regbundock/1002-Connection_Unit/1002-Connection_Unit.png

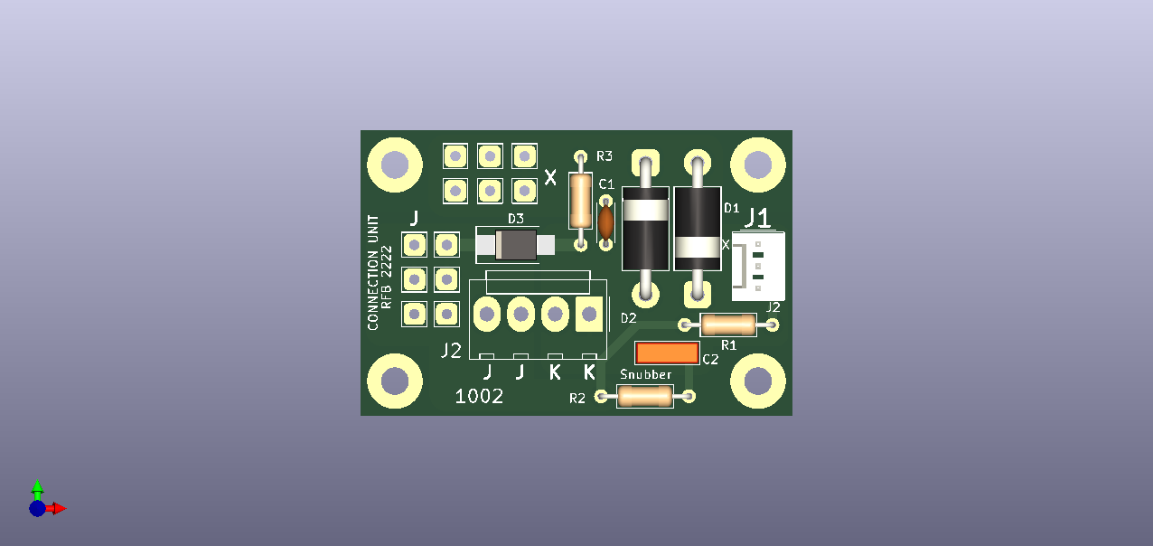
1002-Connection_Unit.png
