regbundock/1002-Connection_Unit/1002-Connection _Unit.pdf

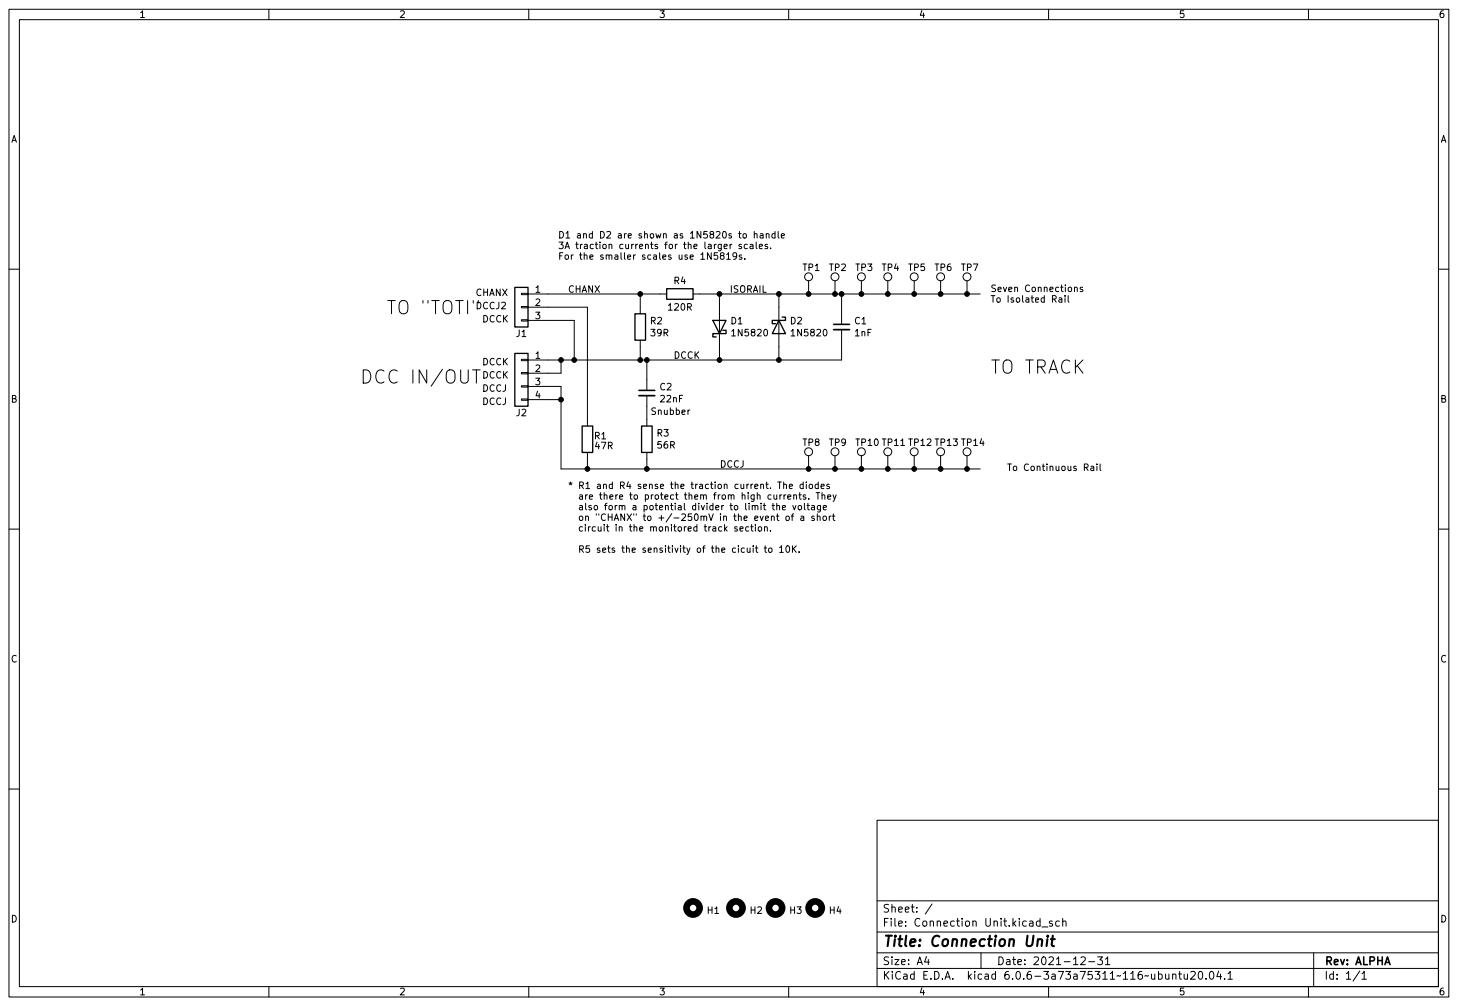
[picture p6: page 1]

Seven Connections To Isolated Rail D1 and D2 are shown as 1N5820s to handle
3A traction currents for the larger scales. For the smaller scales use 1N5819s.

To Continuous Rail TO "TOTI"

* R1 and R4 sense the traction current. The diodes
are there to protect them from high currents. They
also form a potential divider to limit the voltage
on "CHANX" to +/-250mV in the event of a short
circuit in the monitored track section.

File: Connection Unit.kicad_sch Sheet: /
Id: 1/1 Title: Connection Unit
