regbundock/1002-Connection_Unit/1002-Connection_Unit.kicad_pcb

## KiCad design 1002-Connection_Unit.kicad_pcb (2022-09-17)

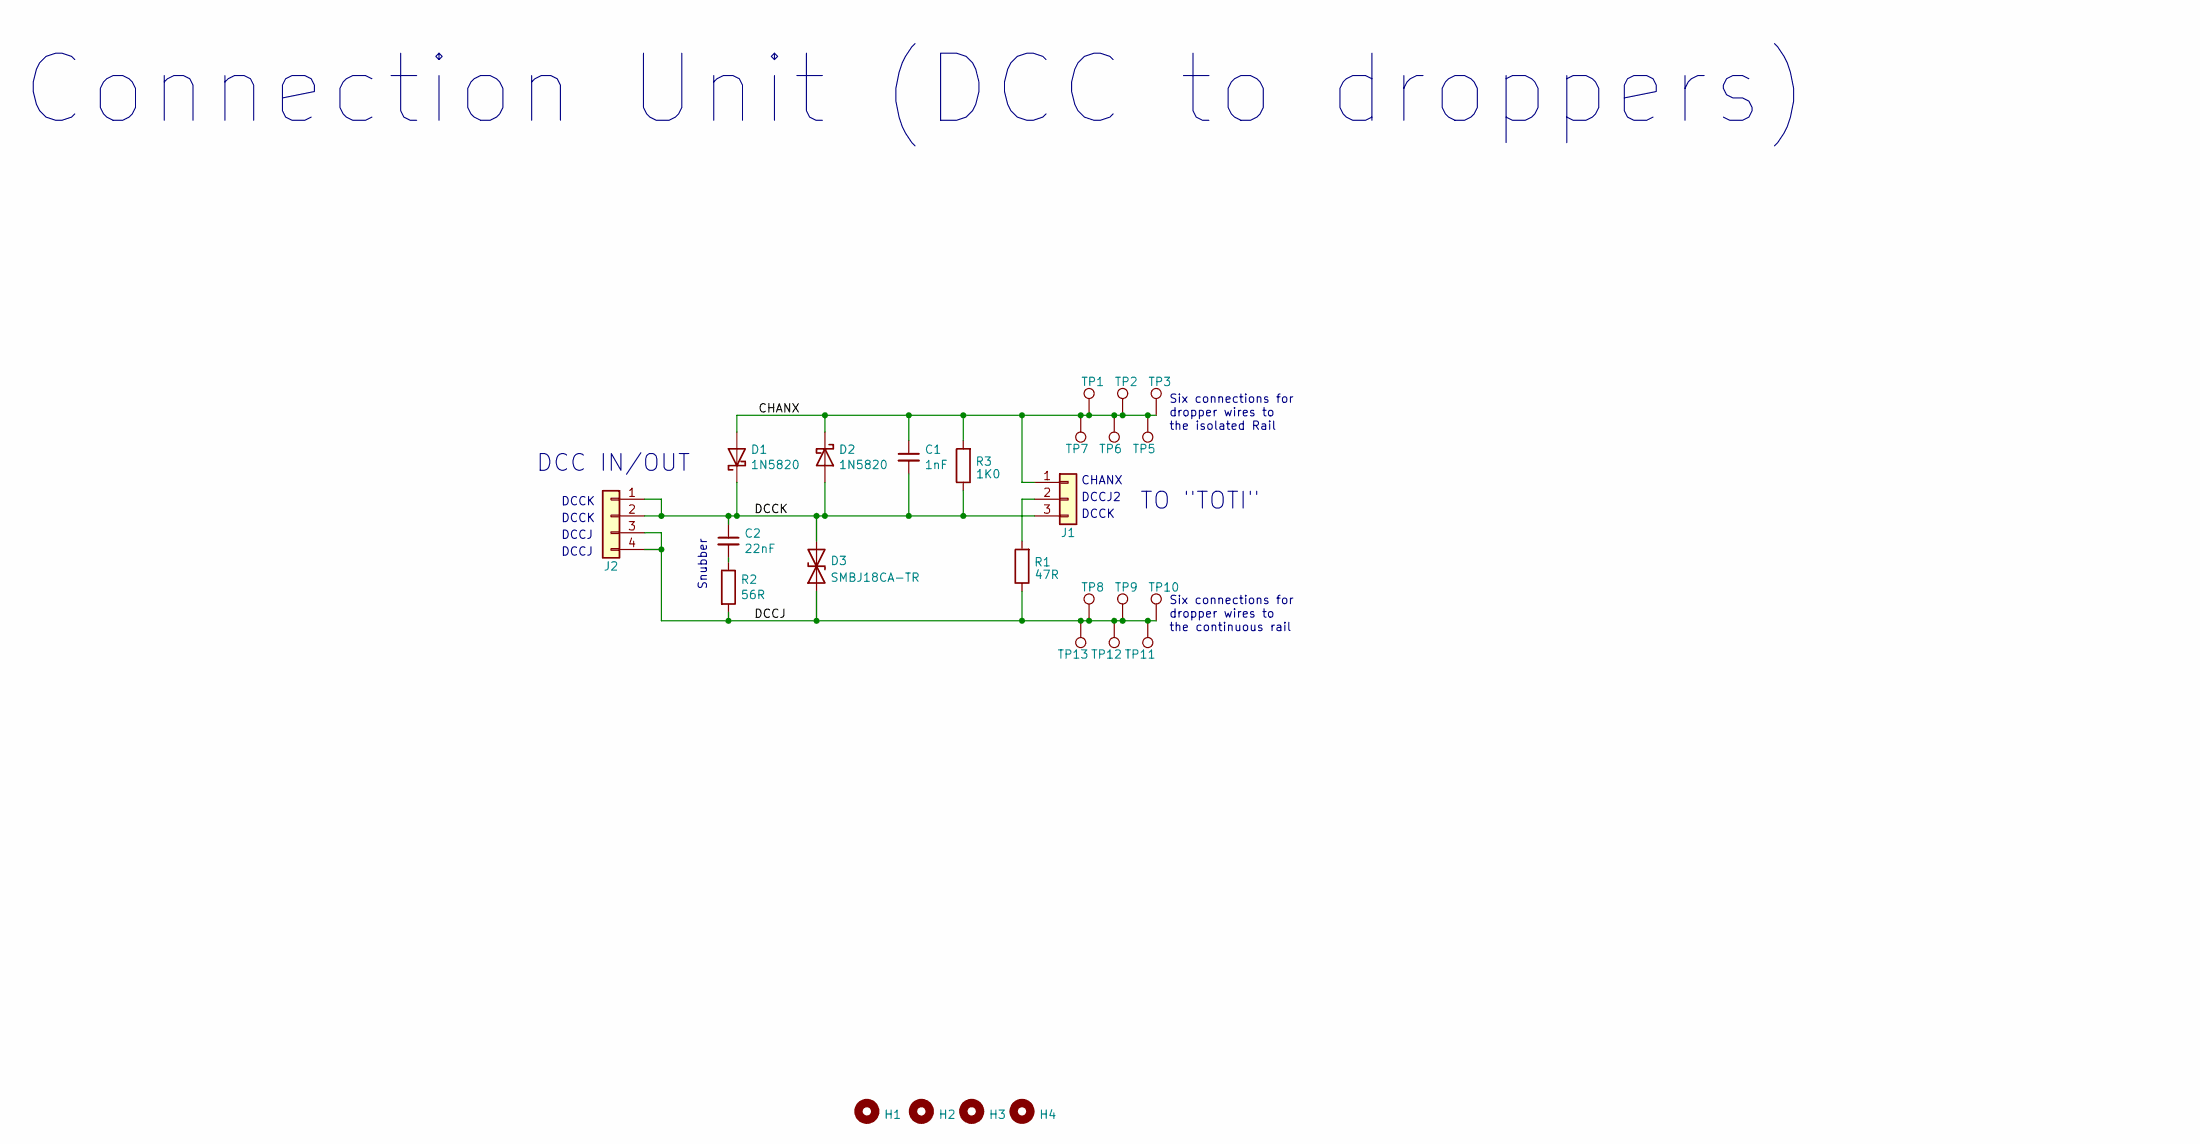
[picture p7: schematic 1002-Connection_Unit.kicad_sch, Connection Unit]

Parts:
C1: 1nF; C_Disc_D4.3mm_W1.9mm_P5.00mm
C2: 22nF; C_Rect_L7.2mm_W2.5mm_P5.00mm_FKS2_FKP2_MKS2_MKP2
D1, D2: 1N5820; D_DO-201AD_P15.24mm_Horizontal
D3: SMBJ18CA-TR; D_SMB_Handsoldering
H1, H2, H3, H4: MountingHole; MountingHole_3.2mm_M3_Pad_TopBottom
J1: Conn_01x03; Molex_KK-254_AE-6410-03A_1x03_P2.54mm_Vertical
J2: Conn_01x04; Molex_KK-396_A-41791-0004_1x04_P3.96mm_Vertical
R1: 47R; R_Axial_DIN0207_L6.3mm_D2.5mm_P10.16mm_Horizontal
R2: 56R; R_Axial_DIN0207_L6.3mm_D2.5mm_P10.16mm_Horizontal
R3: 1K0; R_Axial_DIN0207_L6.3mm_D2.5mm_P10.16mm_Horizontal
TP1, TP2, TP3, TP5, TP6, TP7, TP8, TP9, TP10, TP11, TP12, TP13: TestPoint; TestPoint_THTPad_2.5x2.5mm_Drill1.2mm

Connections:
/CHANX: C1.1, D1.2 (A), D2.1 (K), J1.1, R3.2, TP1.1, TP2.1, TP3.1, TP5.1, TP6.1, TP7.1
/DCCJ: D3.1 (A1), J2.3, J2.4, R1.1, R2.2, TP8.1, TP9.1, TP10.1, TP11.1, TP12.1, TP13.1
/DCCK: C1.2, C2.1, D1.1 (K), D2.2 (A), D3.2 (A2), J1.3, J2.1, J2.2, R3.1
unnamed: C2.2, R2.1
unnamed: J1.2, R1.2

Notes on the sheet:
DCCK
TO "TOTI"
Six connections for dropper wires to the continuous rail
Six connections for dropper wires to the isolated Rail
DCCJ
CHANX
DCCJ2
Snubber
Connection Unit (DCC to droppers)
DCC IN/OUT

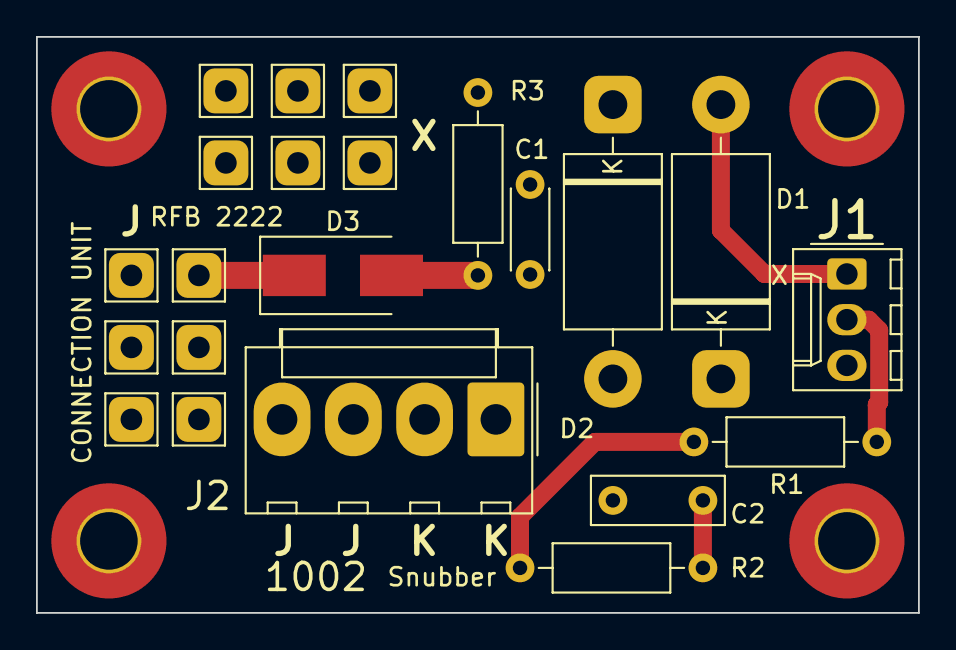
[picture p8: board 1002-Connection_Unit.kicad_pcb from above]

Board: 2 copper layers, 49.0 x 32.0 mm, 26 parts (0 on the bottom side), 5 nets.
